baconspoon85/la-lettre/La Cuillère - Triple Stagger Hotswap/readme.md

La Cuillere Front View

La Cuillère is a drop in PCB designed for La Lettre, by somepin. The original case and plate support a QAZ-like, traditional row-stagger layout. Together with the modified plate file in this directory, La Cuillère Hotswap PCB supports three layouts:

- Traditional row stagger, with 0.25u stagger between the top two alpha rows and 0.5u stagger between the bottom two
- Uniform row stagger, with a uniform 0.25u stagger between rows
- “Alpha” row stagger, where the top two alpha rows are ortholinear and the bottom alpha is staggered 0.5u (as with traditional row stagger) 

la-cuillère---tripple-stagger-pcb-for-la-lettre-by-somepin

The modified plate and PCB are compatible with the original case design, provided that consideration is made for mounting a USB-C daughterboard in the bottom case. This repository also includes design files for a modified case (top and bottom) which has mounting for a C Series Unified Daughterboard (UDB): 

https://unified-daughterboard.github.io/#/?id=unified-daughterboard

Modifications to La Lettre case for La Cuillère:

- UDB mounting added to bottom case in place of ProMicro mounting
- Closed viewing window in bottom case and embossed the name "La Cuillere" on the underside
- Removed screw entry points which were visible from the back of the case
- Closure screws on the rear and front of the case bottom were  moved to the left and right side to hide the screw entry points, 
which are visible from the rear on the original model
- Udercut added to the sides
- Redesined USB port for level entry (parallel to desk)
- Expanded top for increased clearance
- Modeled screw holed for threaded machine screw tapping
- Overall case height is raised by approx. 1mm to accomodate mounting
- Embossed case underside to accomodate SKUF silicone feet:  https://github.com/Zambumon/SKUF

Alternate layout support is achieved by using unconventional key sizes on the interior columns, rather than by using multiple case tops and plates. This, combined with the use of kailh hotswap sockets will allow for multiple quick rebuilds to trial until you find your preferred row stagger. 

Firmware is QMK with vial. The source is minimal, with the intention being for end user to either setup their desired keymap in Vial, or to flesh out the firmware themselves. Note that La Cuillere uses RP2040, so the compiled Vial hex is a UF2 file.

The PCB has been prototyped, flashed with the vial hex in this repo and tested. No issues there.
Prototypes of the first iteration of the case have been printed in both PLA (FDM) and nylon (MJF). After the prototype round, some minor modifications were made, and the mounting screw holes were remodeled for threaded machine screw holes (M2x0.4 6H 6mm). A milled prototype of the final case design is pending as of 4/7/2024.

La Cuillere Side View
La Cuillere Rear View
434347585_339994722383188_2484670211822083277_n
434336551_793017306040206_5648405254212680459_n
432507778_1146231560055321_1128930338330979377_n
434771373_957041872763355_3705679784430354849_n
434726009_724846703062193_7743425114401481803_n
