baconspoon85/la-lettre/La Cuillère - Triple Stagger Hotswap/Case/La Cuillere Bottom Drawing (Threaded Hole Notes).pdf

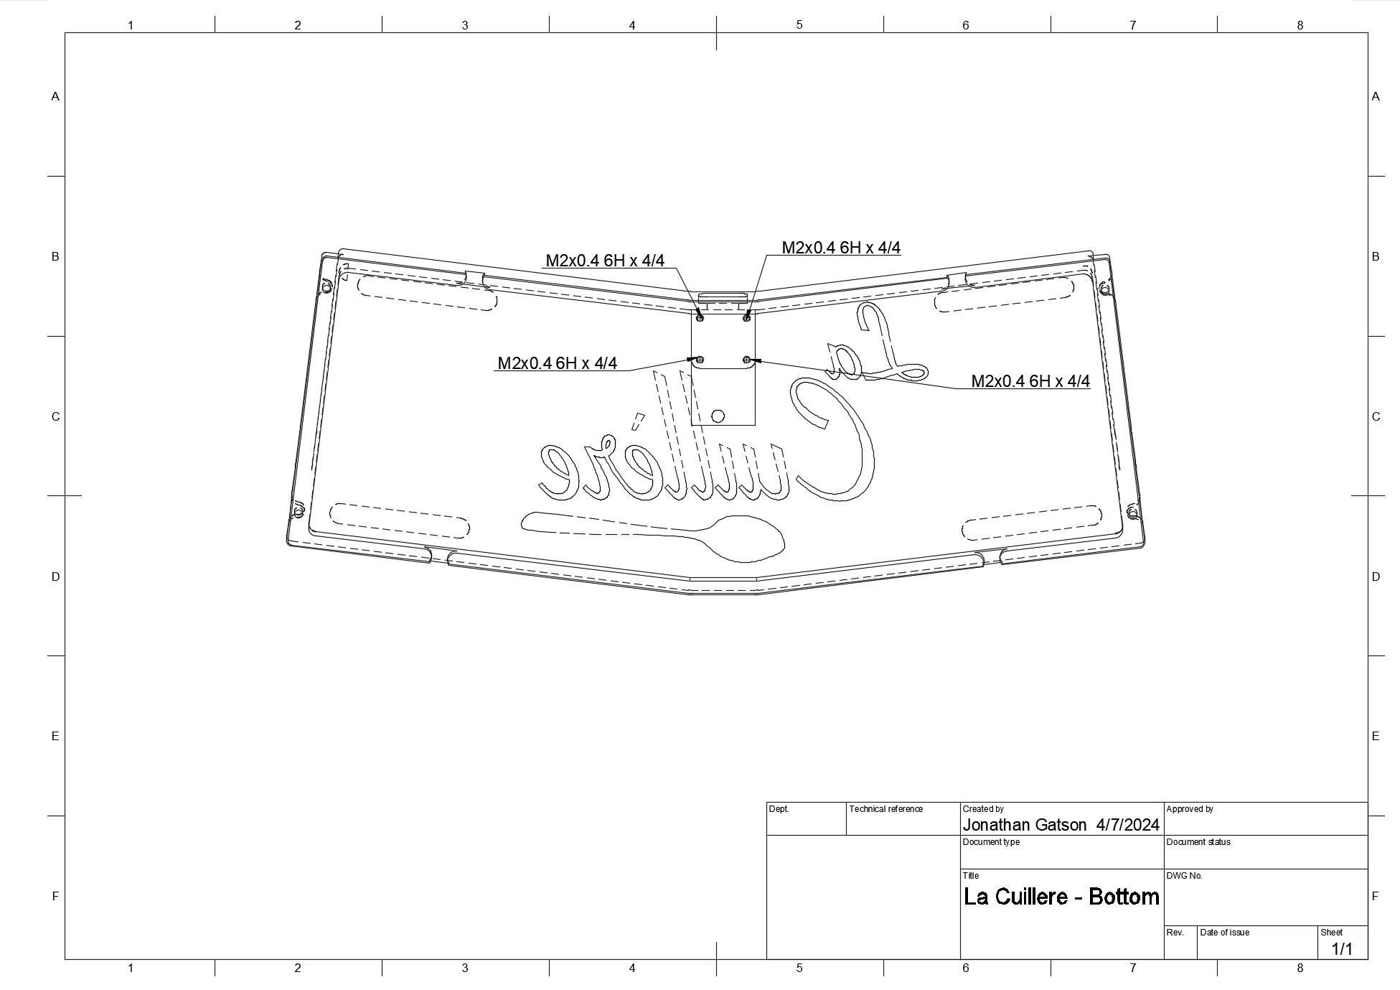
[picture p1: page 1]
