baconspoon85/la-lettre/La Cuillère - Triple Stagger Hotswap/Case/La Cuillere Top Drawing (Threaded Hole Notes).pdf

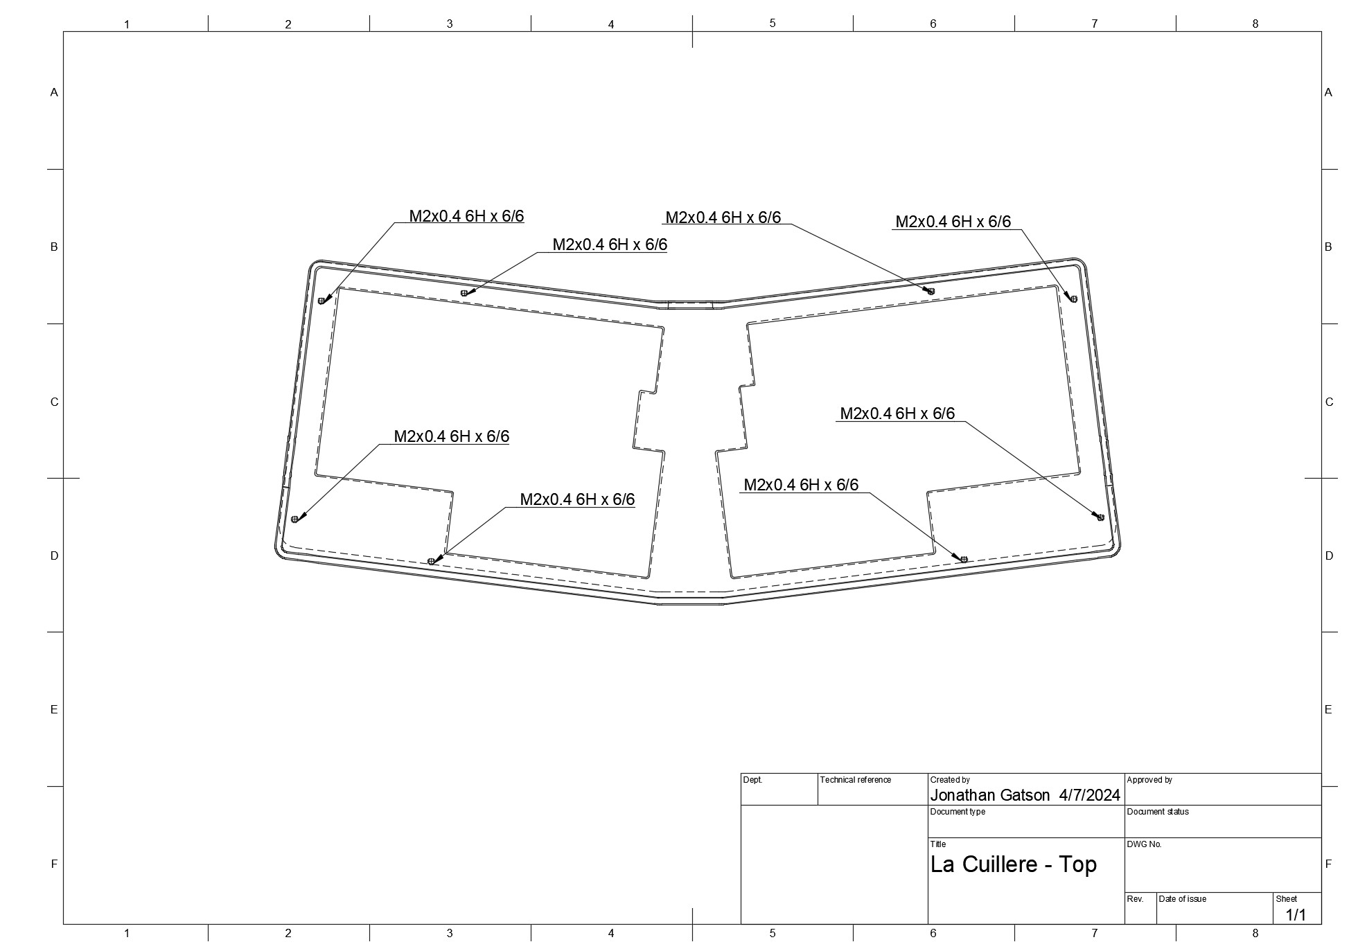
[picture p2: page 1]
