baconspoon85/la-lettre/La Cuillère - Triple Stagger Hotswap/Art/la-cuillere---tripple-stagger-pcb-for-la-lettre.png

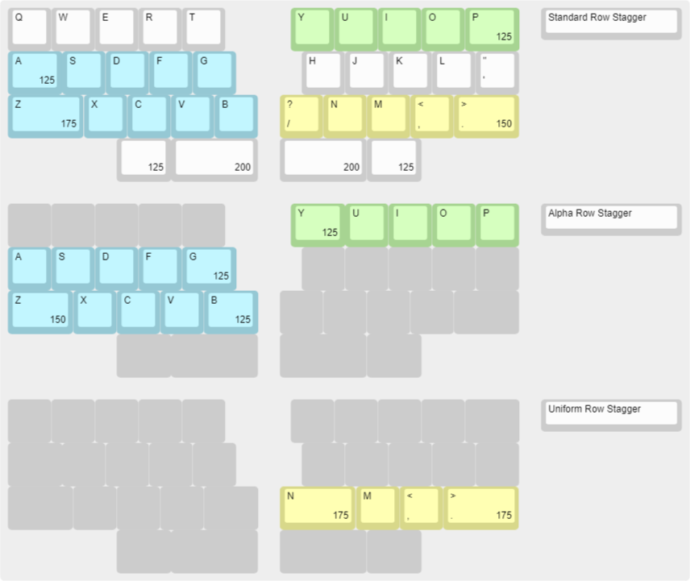
La Cuillère - Triple Stagger Hotswap/Art/la-cuillere---tripple-stagger-pcb-for-la-lettre.png
