baconspoon85/la-lettre/La Cuillère - Triple Stagger Hotswap/PCB (KiCad)/pcb-bottom.png

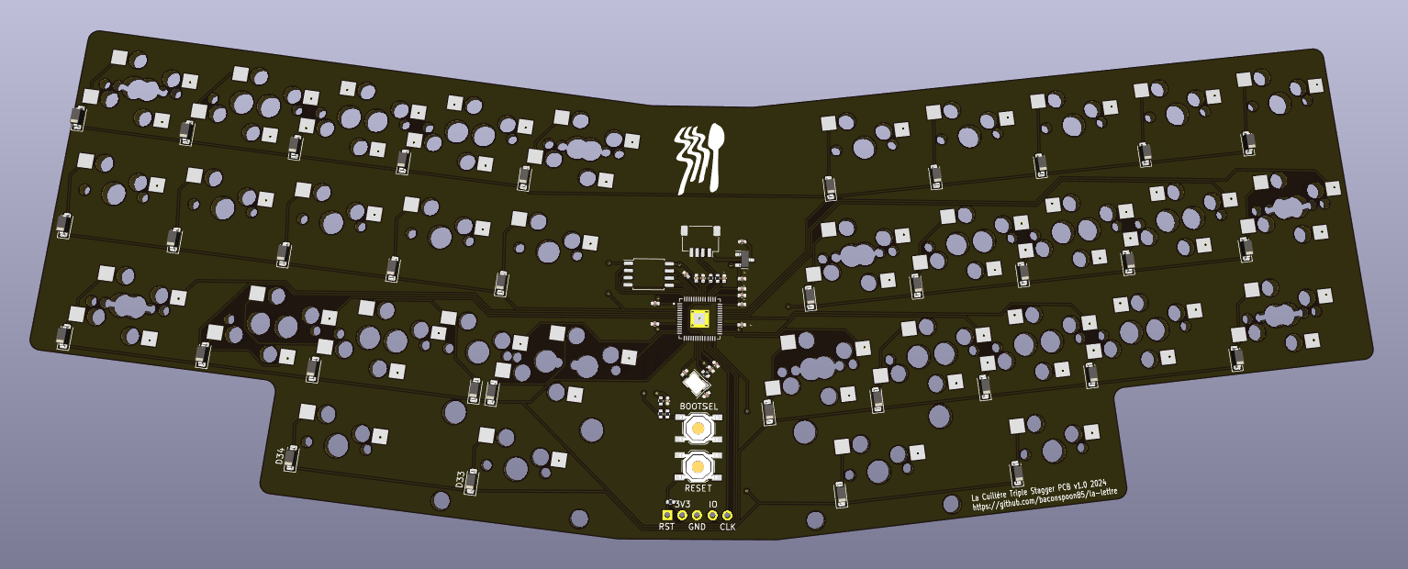
La Cuillère - Triple Stagger Hotswap/PCB (KiCad)/pcb-bottom.png
