baconspoon85/la-lettre/La Cuillère - Triple Stagger Hotswap/PCB (KiCad)/pcb-top.png

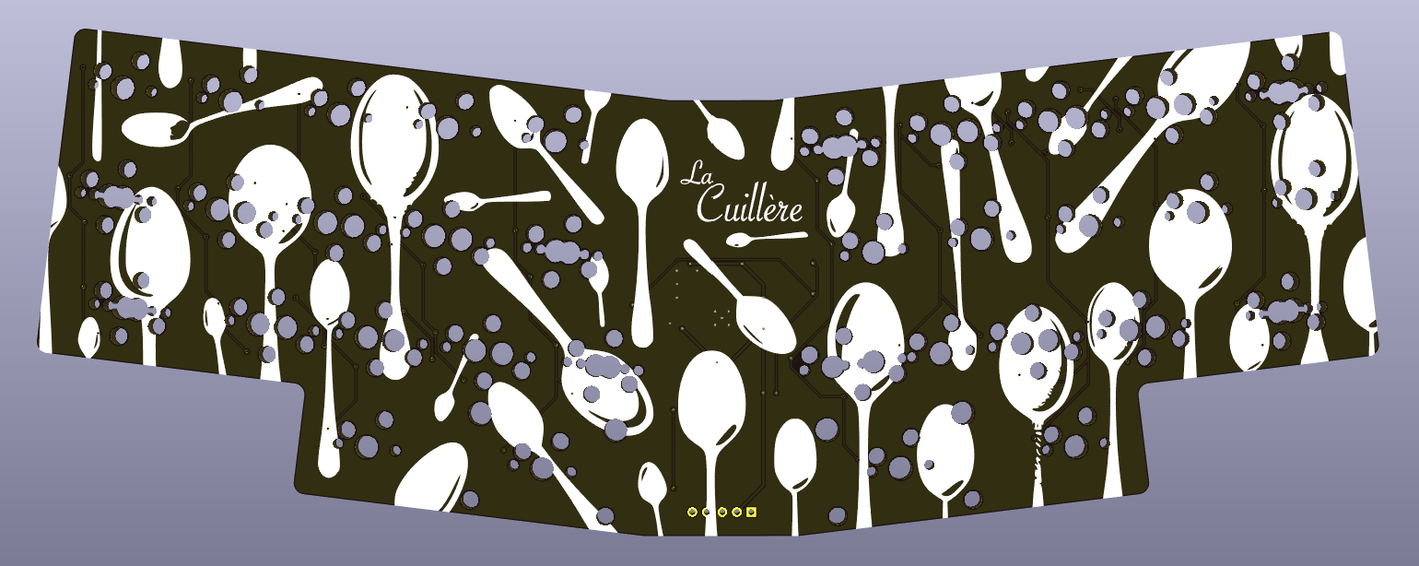
La Cuillère - Triple Stagger Hotswap/PCB (KiCad)/pcb-top.png
