baconspoon85/la-lettre/La Cuillère - Triple Stagger Hotswap/PCB (KiCad)/Fabrication Files/la-cuillère-bom.csv

Comment | Designator | Footprint | JLCPCB Part#(optional)
1u | C_1V1_1 | C_0402_1005Metric | C52923
100n | C_1V1_2 | C_0402_1005Metric | C1525
100n | C_1V1_3 | C_0402_1005Metric | C1525
10u | C_3V3_1 | C_0402_1005Metric | C15525
1u | C_3V3_2 | C_0402_1005Metric | C52923
100n | C_3V3_3 | C_0402_1005Metric | C1525
100n | C_3V3_4 | C_0402_1005Metric | C1525
100n | C_3V3_5 | C_0402_1005Metric | C1525
100n | C_3V3_6 | C_0402_1005Metric | C1525
100n | C_3V3_7 | C_0402_1005Metric | C1525
100n | C_3V3_8 | C_0402_1005Metric | C1525
100n | C_3V3_9 | C_0402_1005Metric | C1525
1u | C_ESD1 | C_0402_1005Metric | C52923
1u | C_ESD2 | C_0402_1005Metric | C52923
100n | C_FLASH1 | C_0402_1005Metric | C1525
22p | C_XTAL1 | C_0402_1005Metric | C1555
22p | C_XTAL2 | C_0402_1005Metric | C1555
1N4148W | D1 | D_SOD-123 | C81598
1N4148W | D2 | D_SOD-123 | C81598
1N4148W | D3 | D_SOD-123 | C81598
1N4148W | D4 | D_SOD-123 | C81598
1N4148W | D5 | D_SOD-123 | C81598
1N4148W | D6 | D_SOD-123 | C81598
1N4148W | D7 | D_SOD-123 | C81598
1N4148W | D8 | D_SOD-123 | C81598
1N4148W | D9 | D_SOD-123 | C81598
1N4148W | D10 | D_SOD-123 | C81598
1N4148W | D11 | D_SOD-123 | C81598
1N4148W | D12 | D_SOD-123 | C81598
1N4148W | D13 | D_SOD-123 | C81598
1N4148W | D14 | D_SOD-123 | C81598
1N4148W | D15 | D_SOD-123 | C81598
1N4148W | D16 | D_SOD-123 | C81598
1N4148W | D17 | D_SOD-123 | C81598
1N4148W | D18 | D_SOD-123 | C81598
1N4148W | D19 | D_SOD-123 | C81598
1N4148W | D20 | D_SOD-123 | C81598
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
BOOTSEL | SW1 | SW_SPST_TL3342 | C318884
RESET | SW2 | SW_SPST_TL3342 | C318884
RP2040 | U1 | QFN40P700X700X90-57N | C2040
W25Q128JVS | U2 | SOIC-8_5.23x5.23mm_P1.27mm | C97521
XC6206P332MR | U3 | SOT-23 | C5446
12MHz | Y1 | Crystal_SMD_3225-4Pin_3.2x2.5mm | C9002
