baconspoon85/la-lettre/La Cuillère - Triple Stagger Hotswap/Art/la cuillere logo vector - with spoon.dxf

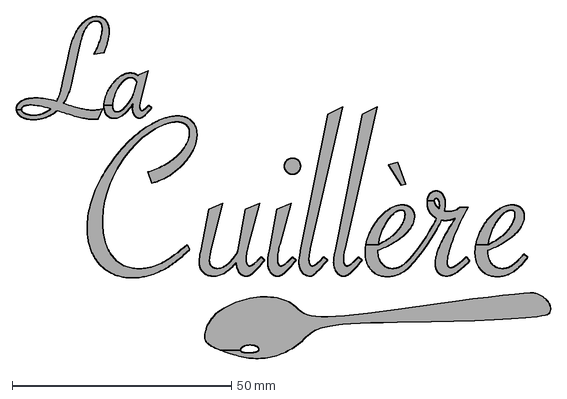
[picture p6: CAD file, 2024-04-07]
La Cuillère - Triple Stagger Hotswap/Art/la cuillere logo vector - with spoon.dxf
121.7 x 77.9 mm
