baconspoon85/la-lettre/La Cuillère - Triple Stagger Hotswap/Case/Illustrator and DXF/PCB Edge.dxf

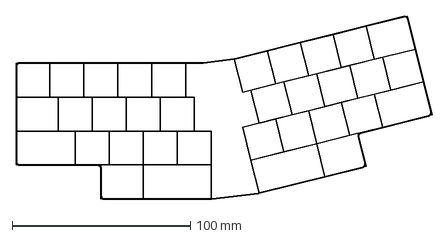
[picture p7: CAD file, 2024-02-11]
La Cuillère - Triple Stagger Hotswap/Case/Illustrator and DXF/PCB Edge.dxf
233.5 x 102.6 mm
