baconspoon85/la-lettre/La Cuillère - Triple Stagger Hotswap/Case/STEP/La Cuillere - Plate.step

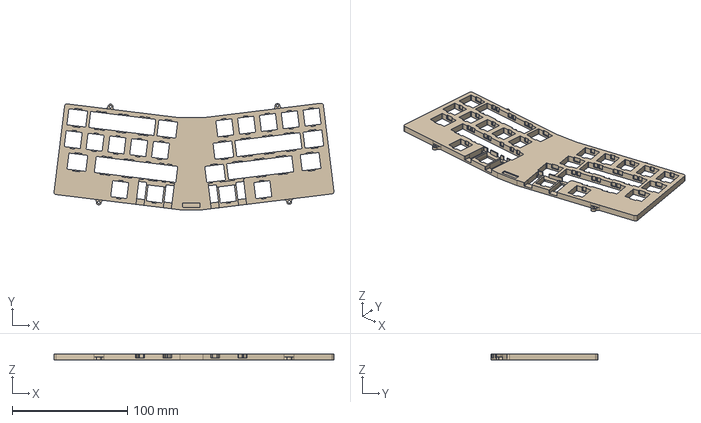
[picture p8: CAD file, 2024-04-08]
La Cuillère - Triple Stagger Hotswap/Case/STEP/La Cuillere - Plate.step
242.6 x 92.3 x 5.00 mm
