baconspoon85/la-lettre/La Cuillère - Triple Stagger Hotswap/Case/STL/La Cuillere - Bottom (Threaded).stl

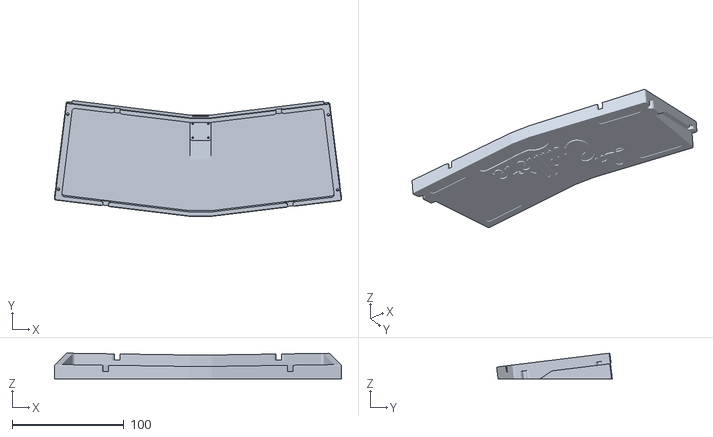
[picture p9: CAD file, 2024-04-08]
La Cuillère - Triple Stagger Hotswap/Case/STL/La Cuillere - Bottom (Threaded).stl
256.8 x 103.6 x 23.0
