baconspoon85/la-lettre/La Cuillère - Triple Stagger Hotswap/Case/Illustrator and DXF/Multi-layout Plate Sketch.dxf

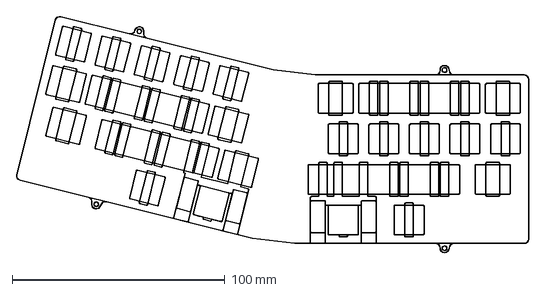
[picture p10: CAD file, 2024-02-11]
La Cuillère - Triple Stagger Hotswap/Case/Illustrator and DXF/Multi-layout Plate Sketch.dxf
241.0 x 111.2 mm
