baconspoon85/la-lettre/La Cuillère - Triple Stagger Hotswap/Case/STEP/La Cuillere - Top (Threaded).step

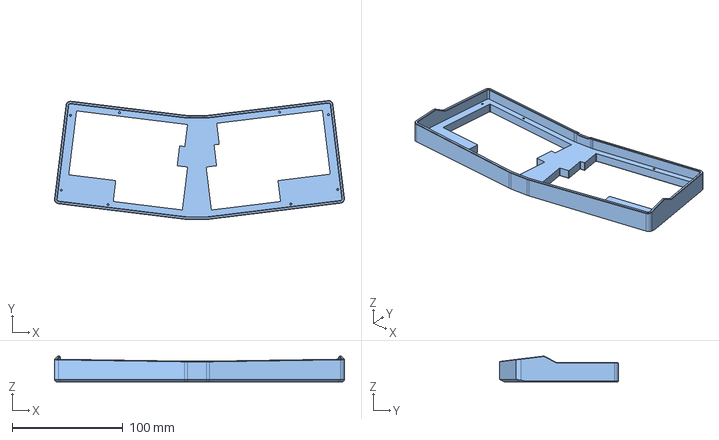
[picture p11: CAD file, 2024-04-07]
La Cuillère - Triple Stagger Hotswap/Case/STEP/La Cuillere - Top (Threaded).step
262.0 x 107.4 x 23.3 mm
