baconspoon85/la-lettre/(list of files, cad)

Other CAD files:
La Cuillère - Triple Stagger Hotswap/Case/STL/La Cuillere - Plate.stl
La Cuillère - Triple Stagger Hotswap/Case/STL/La Cuillere - Top (Threaded).stl
