baconspoon85/la-lettre/La Cuillère - Triple Stagger Hotswap/PCB (KiCad)/la-cuillère-triple-stagger-hotswap-pcb.kicad_pcb

## KiCad design La Cuillère - Triple Stagger Hotswap/PCB (KiCad)/la-cuillère-triple-stagger-hotswap-pcb.kicad_pcb (2024-02-12)

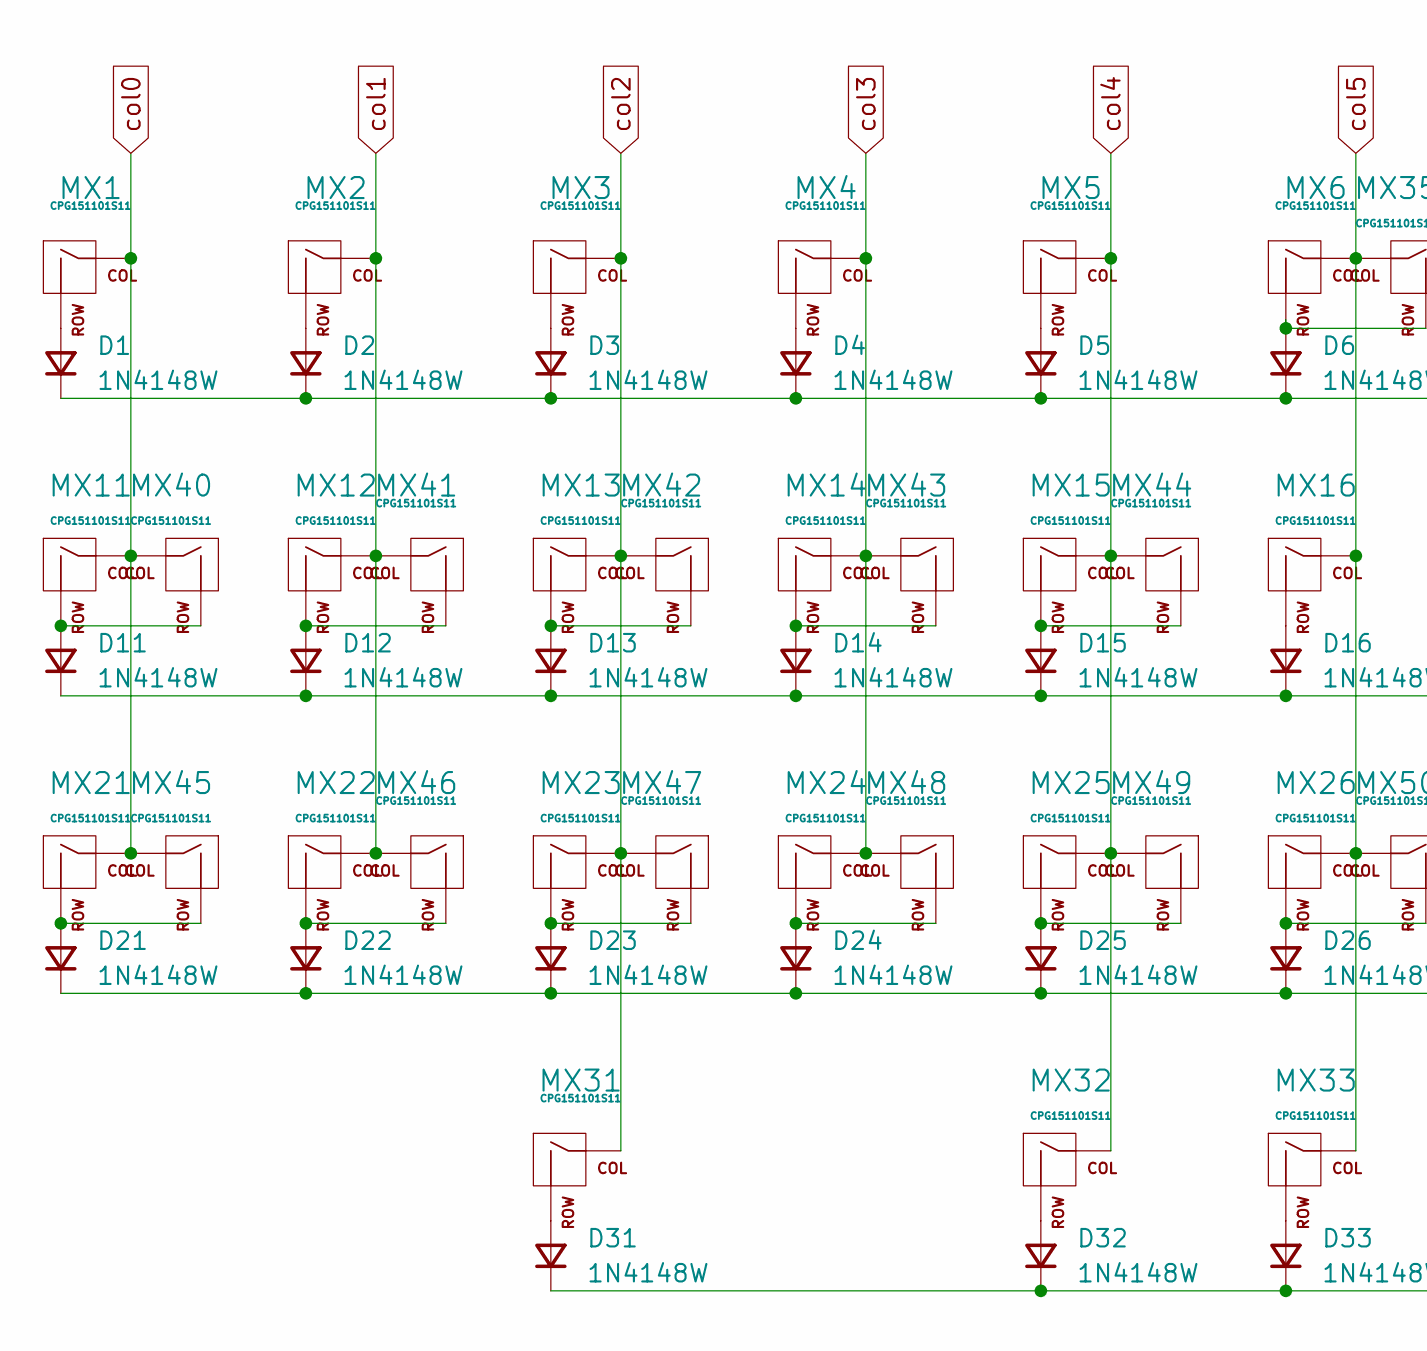
[picture p12: schematic Switch Matrix-hotswap.kicad_sch, part in row 1, column 1]

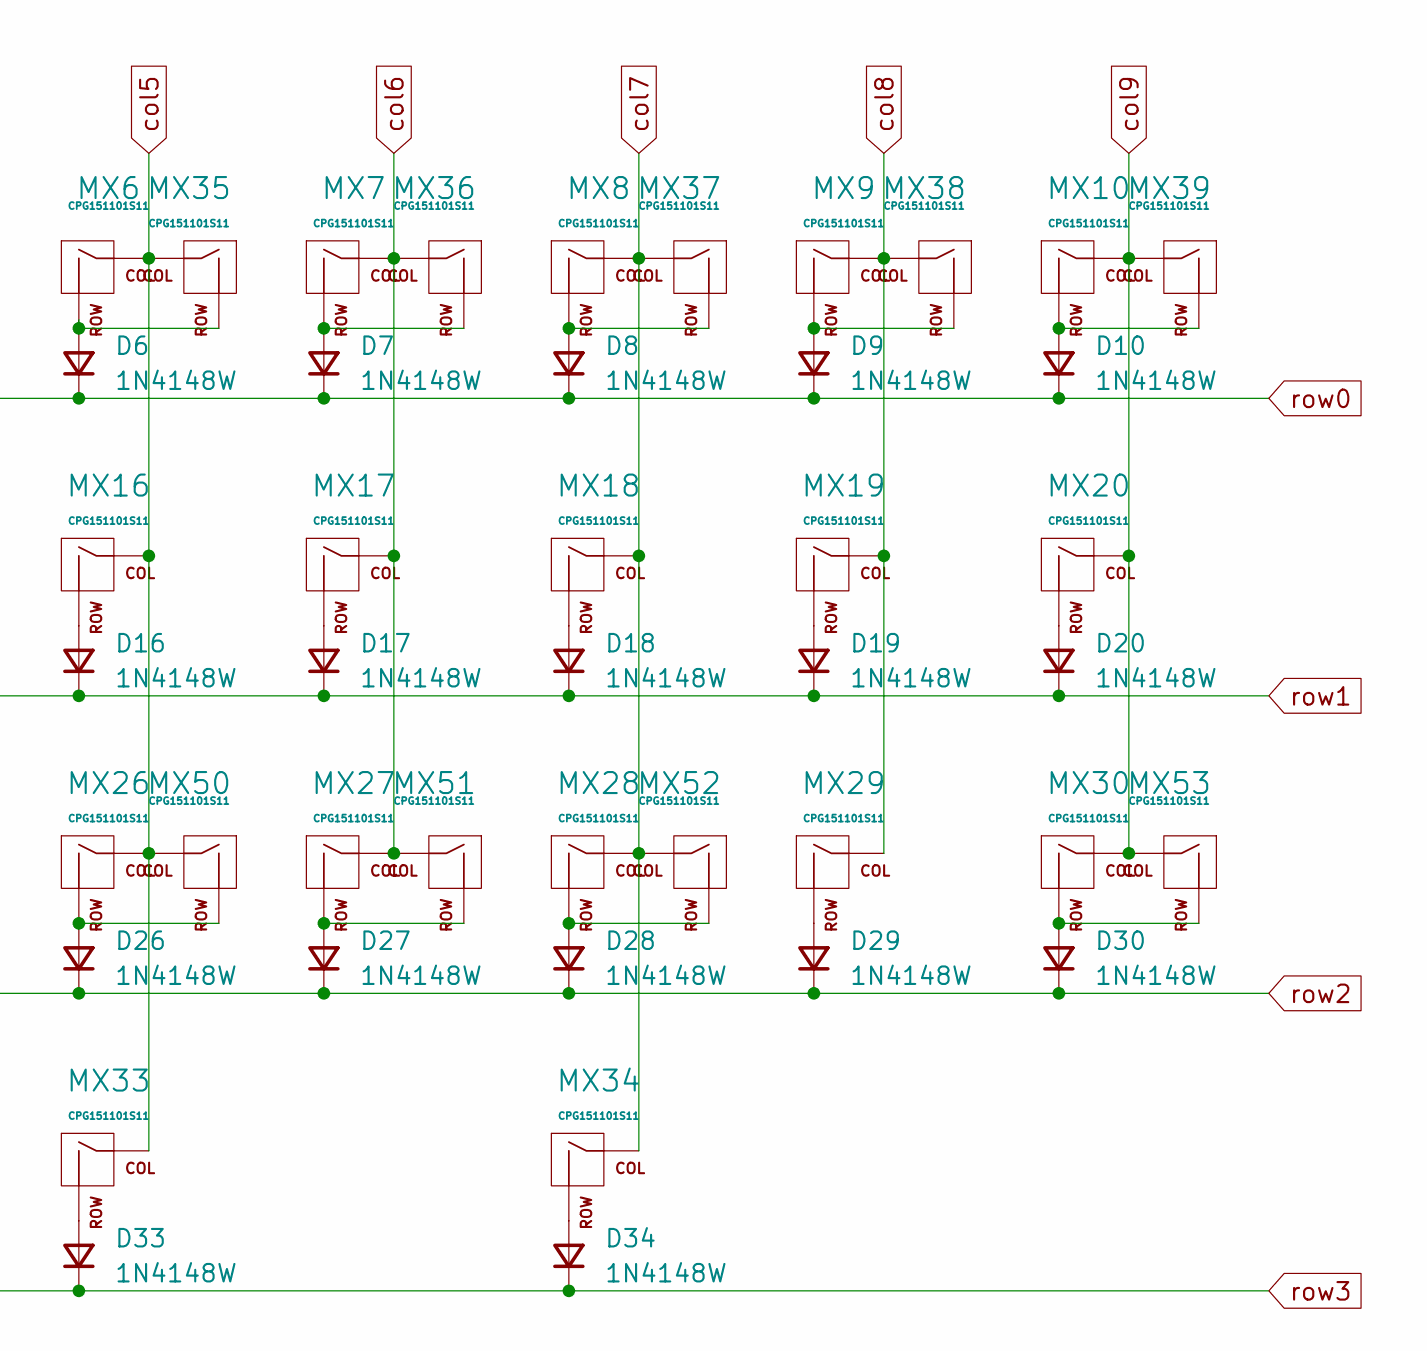
[picture p13: schematic Switch Matrix-hotswap.kicad_sch, part in row 1, column 2]

Parts:
D1, D2, D3, D4, D5, D6, D7, D8, D9, D10, D11, D12, D13, D14, D15, D16, D17, D18, D19, D20, D21, D22, D23, D24, D25, D26, D27, D28, D29, D30, D31, D32, D33, D34: 1N4148W; D_SOD-123
MX1, MX2, MX3, MX4, MX5, MX6, MX7, MX8, MX9, MX11, MX12, MX13, MX14, MX15, MX16, MX17, MX18, MX19, MX20, MX22, MX23, MX24, MX26, MX27, MX28, MX29, MX36, MX37, MX38, MX39, MX41, MX42, MX43, MX46, MX47, MX48, MX49, MX51, MX52: CPG151101S11; MXOnly-1U-Hotswap; LCSC C2803348
MX10, MX25, MX31, MX34, MX35, MX40, MX44: CPG151101S11; MXOnly-1.25U-Hotswap; LCSC C2803348
MX21, MX53: CPG151101S11; MXOnly-1.5U-Hotswap; LCSC C2803348
MX30, MX45, MX50: CPG151101S11; MXOnly-1.75U-Hotswap; LCSC C2803348
MX32, MX33: CPG151101S11; MXOnly-2U-Hotswap-ReversedStabilizers; LCSC C2803348

Connections:
unnamed: D1.2 (A), MX1.2 (ROW)
unnamed: D2.2 (A), MX2.2 (ROW)
unnamed: D3.2 (A), MX3.2 (ROW)
unnamed: D4.2 (A), MX4.2 (ROW)
unnamed: D5.2 (A), MX5.2 (ROW)
unnamed: D6.2 (A), MX6.2 (ROW), MX35.2 (ROW)
unnamed: D7.2 (A), MX7.2 (ROW), MX36.2 (ROW)
unnamed: D8.2 (A), MX8.2 (ROW), MX37.2 (ROW)
unnamed: D9.2 (A), MX9.2 (ROW), MX38.2 (ROW)
unnamed: D10.2 (A), MX10.2 (ROW), MX39.2 (ROW)
unnamed: D11.2 (A), MX11.2 (ROW), MX40.2 (ROW)
unnamed: D12.2 (A), MX12.2 (ROW), MX41.2 (ROW)
unnamed: D13.2 (A), MX13.2 (ROW), MX42.2 (ROW)
unnamed: D14.2 (A), MX14.2 (ROW), MX43.2 (ROW)
unnamed: D15.2 (A), MX15.2 (ROW), MX44.2 (ROW)
unnamed: D16.2 (A), MX16.2 (ROW)
unnamed: D17.2 (A), MX17.2 (ROW)
unnamed: D18.2 (A), MX18.2 (ROW)
unnamed: D19.2 (A), MX19.2 (ROW)
unnamed: D20.2 (A), MX20.2 (ROW)
unnamed: D21.2 (A), MX21.2 (ROW), MX45.2 (ROW)
unnamed: D22.2 (A), MX22.2 (ROW), MX46.2 (ROW)
unnamed: D23.2 (A), MX23.2 (ROW), MX47.2 (ROW)
unnamed: D24.2 (A), MX24.2 (ROW), MX48.2 (ROW)
unnamed: D25.2 (A), MX25.2 (ROW), MX49.2 (ROW)
unnamed: D26.2 (A), MX26.2 (ROW), MX50.2 (ROW)
unnamed: D27.2 (A), MX27.2 (ROW), MX51.2 (ROW)
unnamed: D28.2 (A), MX28.2 (ROW), MX52.2 (ROW)
unnamed: D29.2 (A), MX29.2 (ROW)
unnamed: D30.2 (A), MX30.2 (ROW), MX53.2 (ROW)
unnamed: D31.2 (A), MX31.2 (ROW)
unnamed: D32.2 (A), MX32.2 (ROW)
unnamed: D33.2 (A), MX33.2 (ROW)
unnamed: D34.2 (A), MX34.2 (ROW)
col0: MX1.1 (COL), MX11.1 (COL), MX21.1 (COL), MX40.1 (COL), MX45.1 (COL); also elsewhere on the board
col1: MX2.1 (COL), MX12.1 (COL), MX22.1 (COL), MX41.1 (COL), MX46.1 (COL); also elsewhere on the board
col2: MX3.1 (COL), MX13.1 (COL), MX23.1 (COL), MX31.1 (COL), MX42.1 (COL), MX47.1 (COL); also elsewhere on the board
col3: MX4.1 (COL), MX14.1 (COL), MX24.1 (COL), MX43.1 (COL), MX48.1 (COL); also elsewhere on the board
col4: MX5.1 (COL), MX15.1 (COL), MX25.1 (COL), MX32.1 (COL), MX44.1 (COL), MX49.1 (COL); also elsewhere on the board
col5: MX6.1 (COL), MX16.1 (COL), MX26.1 (COL), MX33.1 (COL), MX35.1 (COL), MX50.1 (COL); also elsewhere on the board
col6: MX7.1 (COL), MX17.1 (COL), MX27.1 (COL), MX36.1 (COL), MX51.1 (COL); also elsewhere on the board
col7: MX8.1 (COL), MX18.1 (COL), MX28.1 (COL), MX34.1 (COL), MX37.1 (COL), MX52.1 (COL); also elsewhere on the board
col8: MX9.1 (COL), MX19.1 (COL), MX29.1 (COL), MX38.1 (COL); also elsewhere on the board
col9: MX10.1 (COL), MX20.1 (COL), MX30.1 (COL), MX39.1 (COL), MX53.1 (COL); also elsewhere on the board
row0: D1.1 (K), D2.1 (K), D3.1 (K), D4.1 (K), D5.1 (K), D6.1 (K), D7.1 (K), D8.1 (K), D9.1 (K), D10.1 (K); also elsewhere on the board
row1: D11.1 (K), D12.1 (K), D13.1 (K), D14.1 (K), D15.1 (K), D16.1 (K), D17.1 (K), D18.1 (K), D19.1 (K), D20.1 (K); also elsewhere on the board
row2: D21.1 (K), D22.1 (K), D23.1 (K), D24.1 (K), D25.1 (K), D26.1 (K), D27.1 (K), D28.1 (K), D29.1 (K), D30.1 (K); also elsewhere on the board
row3: D31.1 (K), D32.1 (K), D33.1 (K), D34.1 (K); also elsewhere on the board

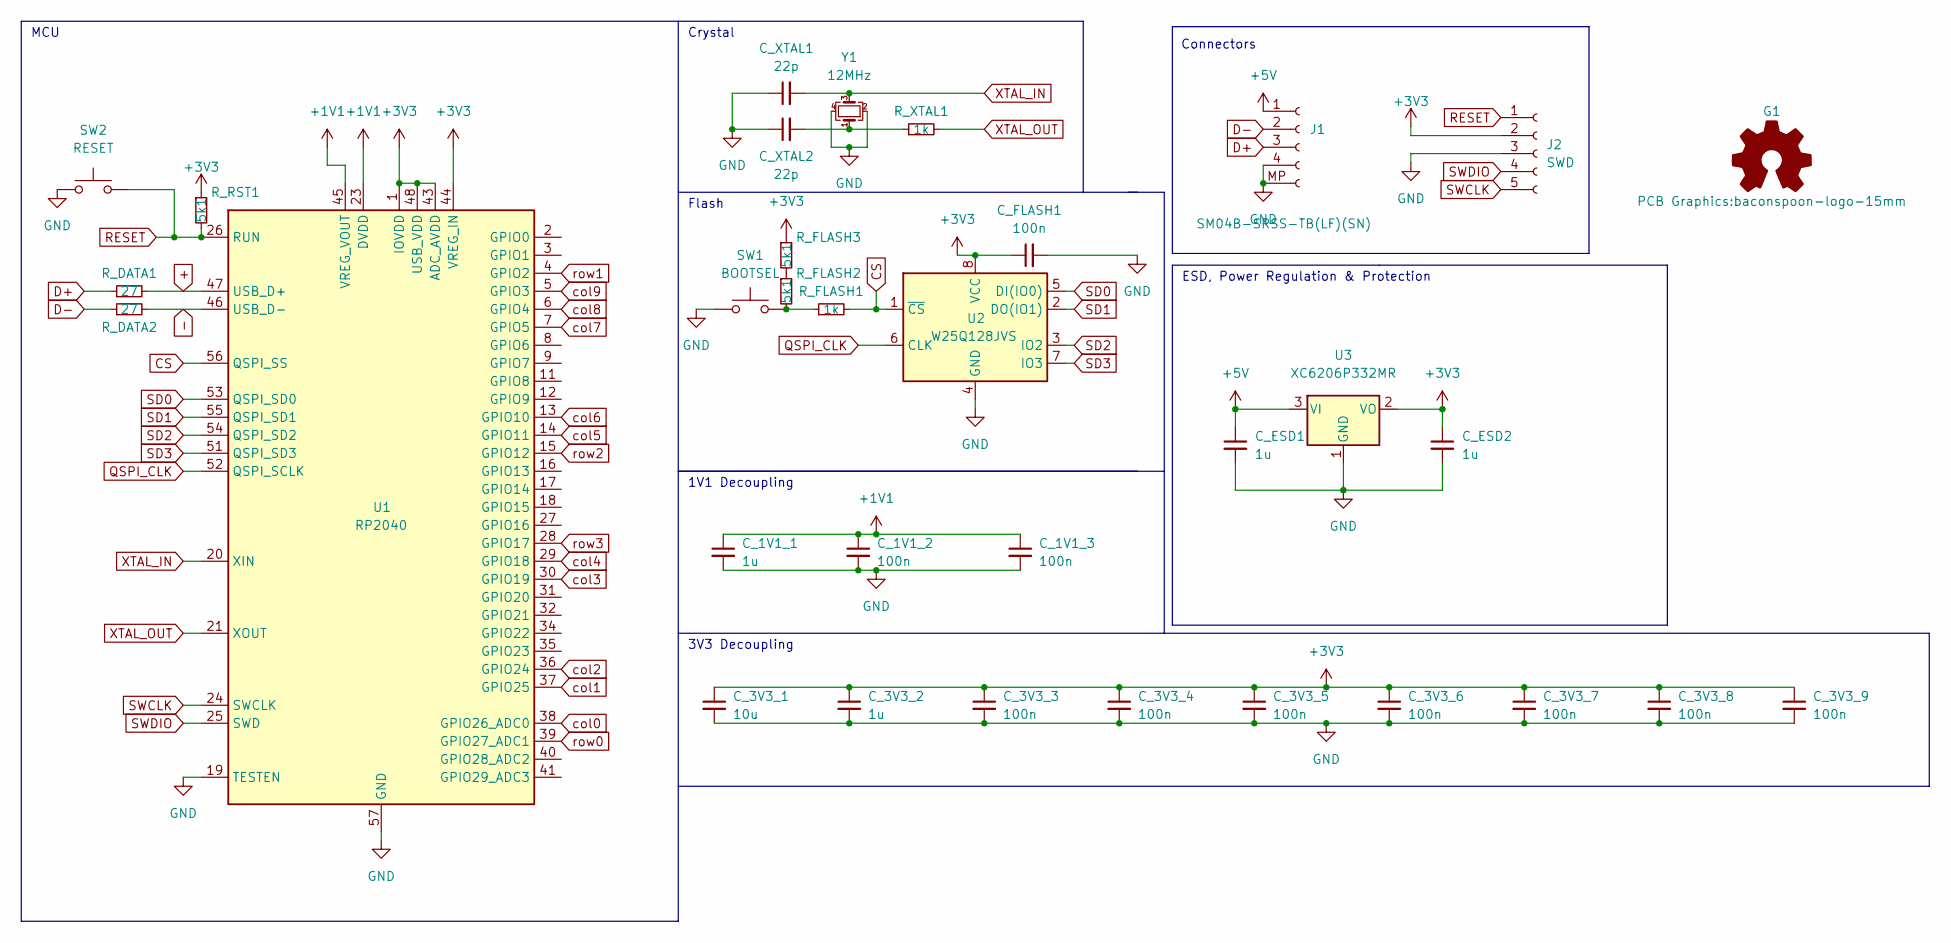
[picture p14: schematic MCU-hotswap.kicad_sch]

Parts:
C_1V1_1, C_3V3_2: 1u; C_0402_1005Metric
C_1V1_2, C_1V1_3, C_3V3_3, C_3V3_4, C_3V3_5, C_3V3_6, C_3V3_7, C_3V3_8, C_3V3_9: 100n; C_0402_1005Metric
C_3V3_1: 10u; C_0402_1005Metric
C_ESD1, C_ESD2: 1u; C_0402_1005Metric
C_FLASH1: 100n; C_0402_1005Metric
C_XTAL1, C_XTAL2: 22p; C_0402_1005Metric
G1: Logo_Open_Hardware_Small; baconspoon-logo-15mm
J1: SM04B-SRSS-TB(LF)(SN); JST_SH_SM04B-SRSS-TB_1x04-1MP_P1.00mm_Horizontal; LCSC C160404
J2: SWD; PinHeader_1x05_P2.54mm_Vertical
R_DATA1, R_DATA2: 27; R_0402_1005Metric
R_FLASH1: 1k; R_0402_1005Metric
R_FLASH2, R_FLASH3: 5k1; R_0402_1005Metric
R_RST1: 5k1; R_0402_1005Metric
R_XTAL1: 1k; R_0402_1005Metric
SW1: BOOTSEL; SW_SPST_TL3342; LCSC C318884
SW2: RESET; SW_SPST_TL3342; LCSC C318884
U1: RP2040; QFN40P700X700X90-57N; LCSC C2040
U2: W25Q128JVS; SOIC-8_5.23x5.23mm_P1.27mm; LCSC C2613930
U3: XC6206P332MR; SOT-23; LCSC C5446
Y1: 12MHz; Crystal_SMD_3225-4Pin_3.2x2.5mm; LCSC C9002

Connections:
+: R_DATA1.2, U1.47 (USB_D+)
+1V1: C_1V1_1.1, C_1V1_2.1, C_1V1_3.1, U1.23 (DVDD), U1.45 (VREG_VOUT), U1.50 (DVDD)
+3V3: C_3V3_1.1, C_3V3_2.1, C_3V3_3.1, C_3V3_4.1, C_3V3_5.1, C_3V3_6.1, C_3V3_7.1, C_3V3_8.1, C_3V3_9.1, C_ESD2.1, C_FLASH1.1, J2.2, R_FLASH3.1, R_RST1.1, U1.1 (IOVDD), U1.10 (IOVDD), U1.22 (IOVDD), U1.33 (IOVDD), U1.42 (IOVDD), U1.43 (ADC_AVDD), U1.44 (VREG_IN), U1.48 (USB_VDD), U1.49 (IOVDD), U2.8 (VCC), U3.2 (VO)
+5V: C_ESD1.1, J1.1, U3.3 (VI)
-: R_DATA2.2, U1.46 (USB_D-)
CS: R_FLASH1.2, U1.56 (QSPI_SS), U2.1 (~CS)
D+: J1.3, R_DATA1.1
D-: J1.2, R_DATA2.1
GND: C_1V1_1.2, C_1V1_2.2, C_1V1_3.2, C_3V3_1.2, C_3V3_2.2, C_3V3_3.2, C_3V3_4.2, C_3V3_5.2, C_3V3_6.2, C_3V3_7.2, C_3V3_8.2, C_3V3_9.2, C_ESD1.2, C_ESD2.2, C_FLASH1.2, C_XTAL1.1, C_XTAL2.1, J1.4, J1.MP, J2.3, SW1.1, SW2.1, U1.19 (TESTEN), U1.57 (GND), U2.4 (GND), U3.1 (GND), Y1.2, Y1.4
unnamed: C_XTAL2.2, R_XTAL1.1, Y1.1
unnamed: R_FLASH1.1, R_FLASH2.2, SW1.2
unnamed: R_FLASH2.1, R_FLASH3.2
QSPI_CLK: U1.52 (QSPI_SCLK), U2.6 (CLK)
RESET: J2.1, R_RST1.2, SW2.2, U1.26 (RUN)
SD0: U1.53 (QSPI_SD0), U2.5 (DI(IO0))
SD1: U1.55 (QSPI_SD1), U2.2 (DO(IO1))
SD2: U1.54 (QSPI_SD2), U2.3 (IO2)
SD3: U1.51 (QSPI_SD3), U2.7 (IO3)
SWCLK: J2.5, U1.24 (SWCLK)
SWDIO: J2.4, U1.25 (SWD)
XTAL_IN: C_XTAL1.2, U1.20 (XIN), Y1.3
XTAL_OUT: R_XTAL1.2, U1.21 (XOUT)
col0: U1.38 (GPIO26_ADC0); also elsewhere on the board
col1: U1.37 (GPIO25); also elsewhere on the board
col2: U1.36 (GPIO24); also elsewhere on the board
col3: U1.30 (GPIO19); also elsewhere on the board
col4: U1.29 (GPIO18); also elsewhere on the board
col5: U1.14 (GPIO11); also elsewhere on the board
col6: U1.13 (GPIO10); also elsewhere on the board
col7: U1.7 (GPIO5); also elsewhere on the board
col8: U1.6 (GPIO4); also elsewhere on the board
col9: U1.5 (GPIO3); also elsewhere on the board
row0: U1.39 (GPIO27_ADC1); also elsewhere on the board
row1: U1.4 (GPIO2); also elsewhere on the board
row2: U1.15 (GPIO12); also elsewhere on the board
row3: U1.28 (GPIO17); also elsewhere on the board

Notes on the sheet:
Connectors
1V1 Decoupling
ESD, Power Regulation & Protection
Crystal
MCU
Flash
3V3 Decoupling

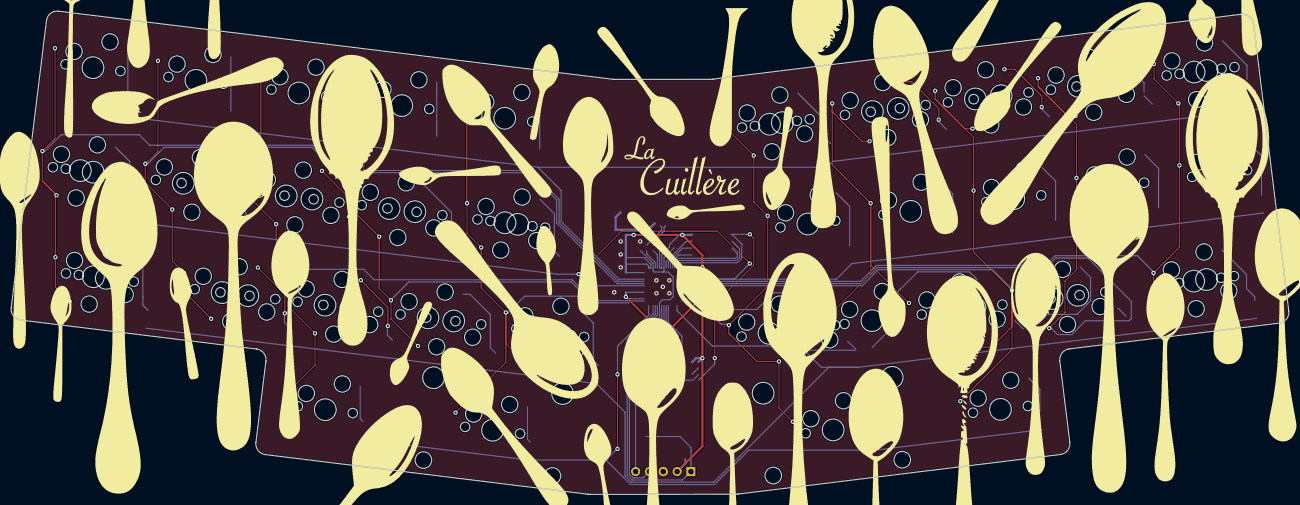
[picture p15: board la-cuillère-triple-stagger-hotswap-pcb.kicad_pcb from above]

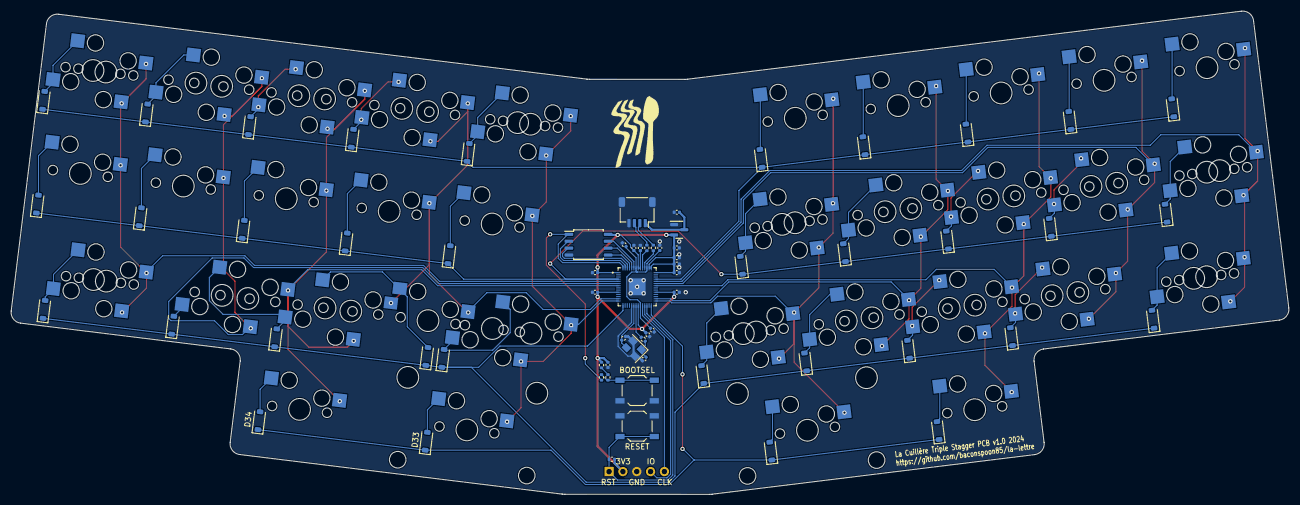
[picture p16: board la-cuillère-triple-stagger-hotswap-pcb.kicad_pcb from below]

Board: 2 copper layers, 234.7 x 88.8 mm, 120 parts (119 on the bottom side), 70 nets.
