baconspoon85/la-lettre/(commit log)

2024-02-11 Initial commit of baconspoon case and PCB (La Cuillère) edits.
    [MCU-hotswap.kicad_sch, Multi-layout Plate Sketch.dxf, PCB Edge.dxf, Switch Matrix-hotswap.kicad_sch, la lettre et la cuillere - bottom.step, la lettre et la cuillere - bottom.stl, la lettre et la cuillere - plate.step, la lettre et la cuillere - plate.stl]
2024-02-12 Add silks to PCB and flipped hotswaps to back. Add readme.
    [MCU-hotswap.kicad_sch, Multi-layout Plate Sketch.dxf, PCB Edge.dxf, Switch Matrix-hotswap.kicad_sch, la lettre et la cuillere - bottom.step, la lettre et la cuillere - bottom.stl, la lettre et la cuillere - plate.step, la lettre et la cuillere - plate.stl]
2024-02-12 Renamed PCB files and dded fabrication files.
    [MCU-hotswap.kicad_sch, Switch Matrix-hotswap.kicad_sch, la-cuillère-bom.csv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]
2024-02-16 Updated README and updated case files with magnet closure model.
    [La Lettre et La Cuillère Case Bottom.step, La Lettre et La Cuillère Case Bottom.stl, La Lettre et La Cuillère Case Top.step, La Lettre et La Cuillère Case Top.stl, La Lettre et La Cuillère Univeral 5mm Plate.step, La Lettre et La Cuillère Univeral 5mm Plate.stl, la lettre et la cuillere - bottom.step, la lettre et la cuillere - bottom.stl]
2024-04-07 update read me and add case, pcb, and firmware
    [Bottom.stl, Bottom_1.stl, Bottom_2.stl, La Cuillere - Bottom (Threaded).stl, La Cuillere - Plate.step, La Cuillere - Plate.stl, La Cuillere - Top (Threaded).step, La Cuillere - Top (Threaded).stl]
2024-04-08 correct holes in case bottom
    [La Cuillere - Bottom (Threaded).stl]
2024-04-08 add drawings - threded hole notes
2024-04-08 added SWD header recess to plate models to avoid shorting solder pads with conductive plate materials
    [La Cuillere - Plate.step, La Cuillere - Plate.stl]
